regular0529/SideEye/(commit log)

2026-08-05 Add SideEye PDR and hardware/comm reference docs
    Scoped push for team parallel development: PDR (module contracts,
    checkpoint roadmap), hardware pin specs, ESPNOW protocol, and camera
    inference record.
2026-08-05 Add wiring doc and checkpoint 1 master hardware test firmware
    WIRING_SideEye.md documents the jumper-wire master board wiring
    (BNO055/NeoPixel/buzzer). checkpoint1_hw_test verifies BNO055 fusion
    and exercises the NeoPixel/buzzer with NeoPixel-only pass/fail
    feedback, no serial monitor required.
2026-08-05 Integrate direct-RMT NeoPixel into checkpoint1, document ESPNOW test MACs
    checkpoint1_hw_test now drives the WCMCU-2812B-12 ring via direct
    ESP-IDF RMT (Adafruit_NeoPixel's RMT init left allow_pd uninitialized,
    which failed transmission on this core/chip combo). Restores the
    left/right color contract instead of the built-in-LED blink-count
    fallback. PDR/WIRING docs updated to reflect the resolved root cause.
    Also records the actual master/slave MACs used for the verified
    ESPNOW round-trip test.
2026-08-05 Add IMU data collector firmware and Edge Impulse uploader
    imu_collector.ino streams BNO055 linear accel + gyro CSV over serial
    at 50Hz. collect_and_upload_imu.py captures fixed windows per label
    and uploads to the SideEye Edge Impulse project (JSON time-series
    ingestion, schema verified live: requires x-file-name header).
2026-08-05 Add 3-2-1 countdown before each IMU recording window
    Pressing Enter used to start capture immediately with no way to know
    when the window actually began. Now prints a countdown and GO/Stop
    markers around the capture window.
2026-08-05 Print per-sample accel range so bad captures are visible immediately
    Row count alone didn't prove real motion was recorded. Now prints
    accel magnitude min/max after each window and flags a suspiciously
    flat capture on a non-idle label.
2026-08-05 Remove input() gating from IMU collector, run fully hands-free
    input() blocks forever with no stdin (e.g. running via a chat-shell
    passthrough with no real TTY). Replaced the per-sample Enter prompt
    with an automatic get-ready beep + pause so the whole 50-sample loop
    runs unattended once started -- you just react to the beeps.
2026-08-05 Reject IMU samples with mostly all-zero rows before upload
    A jumper wire flexing loose during head movement makes the BNO055
    driver return all-zero rows silently instead of erroring. Two 'left'
    samples uploaded this way and had to be deleted manually from Edge
    Impulse. Now skipped client-side when >30% of a window's rows are
    all-zero.
2026-08-05 Mark checkpoint 3 dataset collection complete
    150 IMU samples (idle/left/right x50) verified in the Edge Impulse
    project via API. Training and on-device deployment are still open.
2026-08-05 Add live IMU turn-signal inference sketch, switch colors to red/blue
    turn_signal_live.ino runs the trained SideEYE_inferencing model on a
    rolling 100-sample/2s window and drives the NeoPixel per prediction.
    Confirmed live: ~2-5ms DSP + <1ms classify, far under the buzzer/
    camera path's 180ms budget. Orange/yellow were indistinguishable at
    USB-safe brightness, so the left/right color contract changed to
    red/blue everywhere (PDR, wiring doc, checkpoint1 demo).
2026-08-05 Debounce turn-signal direction changes to fix return-swing flicker
    Leaning right then returning to center briefly produces a signal the
    model reads as 'left' -- training data was static held-lean windows,
    never the natural lean-then-return gesture. idle is still accepted
    instantly (fail-safe), but switching between left and right now needs
    two consecutive matching classifications so a single return-swing
    blip can't flip the indicated direction.
2026-08-05 Switch turn-signal logic to instant-react + 3s hold-lock
    React on the very first left/right classification (no more waiting
    for two confirmations), then lock that color for 3s ignoring all
    classifications -- including the return-swing blip -- before judging
    again. idle still reacts instantly once the lock expires.
2026-08-05 Mark checkpoint 3 complete as proof of concept
    Live IMU classification -> NeoPixel turn signal confirmed working
    end to end. 500ms-window retrain for faster reaction regressed
    accuracy to 68% -- deferred, original 150-sample dataset preserved
    in the Edge Impulse project for a later retune.
2026-08-05 Add checkpoint 4: turn signal + ESPNOW alert round trip
    Master runs the IMU classifier and drives the NeoPixel turn signal
    instantly on lean. Left-lean (slave's side) requests a capture over
    ESPNOW using the shared protocol.h; slave has no camera yet so it
    stubs vehicleFound=1 immediately. Right-lean (master's own side)
    stubs locally the same way. Measured round trip: 3ms, far under the
    1s MVP target. Camera stubs get replaced with real vision in
    checkpoint 5.
2026-08-05 Add buzzer volume test using LEDC PWM duty as a volume knob
    tone() only drives a full-swing square wave with no loudness control.
    Using ledcAttach/ledcWrite instead lets duty cycle act as volume
    (tested at 50/255, confirmed audible at a reasonable level).
2026-08-05 Add README entry point, flag PROJECT_RECORD.md as pre-SideEye
    A teammate started training vehicle detection under the old demo's
    mouse/tumbler/background classes and project (1078233) instead of
    SideEye's vehicle/background classes and project (1079933) -- there
    was no top-level pointer to PDR_SideEye.md as the source of truth,
    and PROJECT_RECORD.md read like current guidance. Added a warning
    banner there and a root README that points straight at the PDR.
2026-08-05 Add web-based IMU collector (AP + browser + local upload bridge)
    Same architecture as the vision collector: ESP32 hosts an AP and a
    recording page (idle/left/right, 3-2-1 countdown, 2s capture via a
    blocking /record endpoint), browser buffers samples in memory, and a
    separate local bridge (imu_upload_bridge.py) holds the EI API key and
    forwards uploads -- no key on the board or in browser JS.
2026-08-05 Rewrite vision handoff as API-driven instead of Studio UI clicks
    Teammate only has an API key, not a Studio collaborator login, so a
    click-through UI guide didn't work. Rewritten to mirror how IMU
    training was actually run this session -- REST API calls their own
    LLM assistant can execute directly, matching xiao-edgeimpulse-train
    skill's verified workflow.
2026-08-05 Add live time-series chart to IMU web collector
    Draws all 6 channels (accX/Y/Z, gyrX/Y/Z) on a canvas right after
    each recording so bad captures (flat, mistimed, noisy) are visible
    immediately during collection instead of only showing up as low
    training accuracy afterward.
2026-08-05 Add Gaussian jitter dataset augmentation for IMU samples
    Expands a small set of real recordings to a target count by adding
    per-channel Gaussian noise scaled to each channel's own observed
    variability. Uploads run 5-way concurrent (ThreadPoolExecutor) since
    this is bulk HTTP calls, not reasoning work -- no need for subagents.
2026-08-05 Switch turn signal to half-ring amber (real blinker look)
    Both directions now use the same amber color; only which half of the
    12-pixel ring lights up differs (pixels 0-5 vs 6-11), matching how an
    actual vehicle turn signal reads at a glance. Also deployed against
    the retrained 500ms/5-label model (idle/left/right real + augmented
    to 500 each via Gaussian jitter, val_accuracy 99% -- pending physical
    verification since augmentation can inflate val accuracy).
2026-08-05 Add checkpoint 6: BLE bridge to phone app (BLE_front.md handoff)
    Copied checkpoint4_turn_signal_espnow to checkpoint6_ble_bridge
    (original untouched, rollback point preserved) and added a NimBLE
    GATT peripheral advertising as "SideEye" with LeanState/AlertEvent/
    DeviceStatus notify characteristics per the phone team's spec.
    Fixed one real incompatibility while wiring it up: BLE_front.md's
    example callbacks were written against NimBLE-Arduino 1.x
    (onConnect(NimBLEServer*)), but the installed 2.5.1 requires
    onConnect(NimBLEServer*, NimBLEConnInfo&) and onDisconnect adds an
    int reason -- confirmed against the actual installed headers, not
    assumed. Compiles and boots clean; WiFi(ESPNOW)+BLE coe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
2026-08-06 Make turn signal actually blink 5 times like a real car indicator
    Real turn signals flash at ~60-120/min; picked 300ms on + 300ms off
    (5 blinks = exactly 3000ms, matching the existing 3s hold window).
    The blink sequence blocks the loop for its full duration, which also
    satisfies "don't recognize new steering while the turn signal is
    running" for free -- no separate lock flag needed since IMU sampling
    simply can't run until the blink call returns.
2026-08-06 Add prompt for extra IMU class training (stop/helmet-on/off/fall) in a separate session
2026-08-06 Apply 5-blink amber turn signal spec to checkpoint4 (WIP, compile pending)
    Ports the same regular spec from turn_signal_live.ino: half-ring
    amber, pixels 0/6 excluded, 300ms on/off x5 = 3s blink. Also adds
    pollReplyDuring() so the ESPNOW alert round-trip isn't delayed behind
    the blocking blink. Committing now as a safety snapshot before
    handing COM14 to a parallel session for IMU class training -- compile
    verification still in progress.
2026-08-06 Add SideEye vision dataset collection, training pipeline, and deploy guide
    Auto-downloads vehicle/background training photos from Wikimedia Commons,
    adds an ESP32 STA-mode camera collector with a browser-based auto-capture
    page, and a REST API script to upload/retrain the SideEYEVision Edge
    Impulse project end to end. Includes a deploy handoff doc with the honest
    72% val-accuracy result and the on-device integration steps.
2026-08-06 Archive project to reproduction-ready state after 1st place win
    Removes intermediate checkpoint sketches, raw datasets, harness
    scripts, unrelated course-exercise docs, and superseded PDR drafts --
    keeps only the final master/slave firmware, shared protocol, trained
    model exports, and a consolidated REPRODUCTION.md covering hardware
    state, architecture, per-board upload steps, and the EI-library
    symbol-collision constraint that shaped the final master/slave split.
    [01_chip_info.ino, 02_blink.ino, 03_serial_echo.ino, 04_touch.ino, 05_wifi_scan.ino, 06_ble_scan.ino, 07_pwm_fade.ino, 08_analog_read.ino]
2026-08-06 Rewrite docs to match final delivered state, unify filenames
    PDR.md/WIRING.md were still describing mid-development plans (3-class
    IMU, red/blue full-ring colors, checkpoint4 stub architecture, dead
    file references) instead of what actually shipped. Update both to the
    final 5-class IMU + amber-turn-signal + master/slave vision split, and
    drop the redundant "_SideEye" suffix from filenames (PDR_SideEye.md ->
    PDR.md, WIRING_SideEye.md -> WIRING.md) and normalize model zip names
    (SideEYE_inferencing_imu5class.zip -> imu_5class.zip,
    SideEYEVision_inferencing_vision.zip -> vision_vehicle_detection.zip).
2026-08-06 Fold VISION_MODEL_DEPLOY.md into REPRODUCTION.md, drop broken skill
    VISION_MODEL_DEPLOY.md referenced dataset/, vision_harness/, and
    firmware/vision_collector, all removed in the prior cleanup pass --
    its still-relevant content (the on-device Edge Impulse fixes: tensor
    arena overflow, PSRAM allocation, camera rotation correction) now
    lives in REPRODUCTION.md 5.1 instead.
    espnow-team-setup (a course-exercise skill unrelated to SideEye)
    depended on team-hub/ and ESPNOW_Peer_Test/, both already deleted --
    removing the skill since its runtime is gone.
2026-08-06 Make xiao-neopixel skill self-contained
    It referenced now-deleted test sketches (neopixel_direct_rmt_test,
    d1_gpio_output_test, checkpoint1_hw_test), NEOPIXEL_DEBUGGING.md, and
    a hardcoded absolute path to this machine's .arduino/libraries --
    all broken by the prior cleanup pass, and none of it portable to
    another project anyway. Inlined the actual working direct-RMT driver
    code instead of pointing at external files.
